sleepumpkin/Deng-s-foc-controller/Dengs FOC V2.0/Dengs FOC V2.0 DIY资料/原理图和PCB/Schematic_DengFOCv2 release.pdf

## LDO降压 5V 3.3V

## DCDC 12/24V 5V

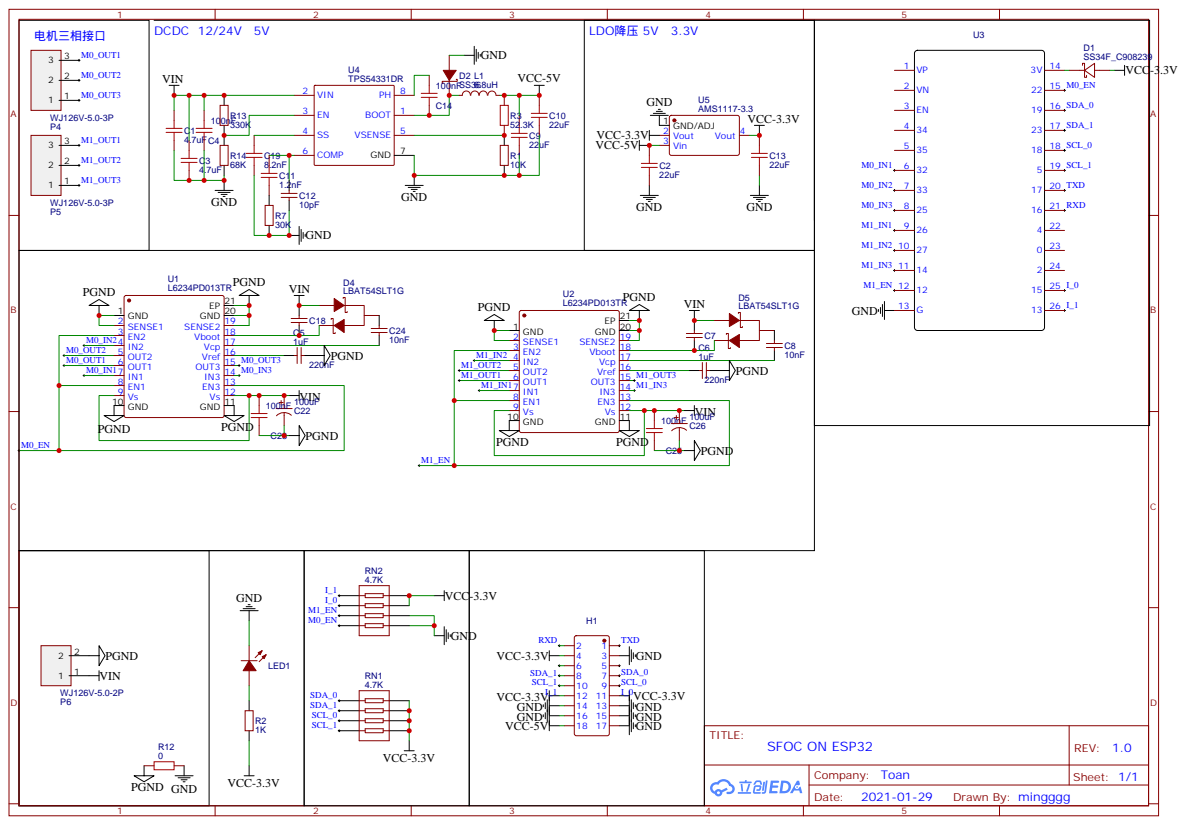
[picture p14: page 1]
