sleepumpkin/Deng-s-foc-controller/(list of files, drawings)

Other design files:
Dengs FOC V2.0/Dengs FOC V2.0 DIY资料/原理图和PCB/PCB_DengFOC v2 release.json
Dengs FOC V2.0/Dengs FOC V2.0 DIY资料/原理图和PCB/SCH_DengFOCv2 release.json
