sleepumpkin/Deng-s-foc-controller/(commit log)

2021-06-05 update arduino environment
2021-06-10 upload new sch
    [BOM.csv]
2021-07-14 Create 灯哥开源FOC V2.0使用文档V1(20200629).pdf
2021-07-15 Update Deng FOC 2.0
    [BOM.csv, PCB_DengFOC v2 release.json, SCH_DengFOCv2 release.json]
